jayanthdevendran-ctrl/Cirrus/3d models/cirrus.step

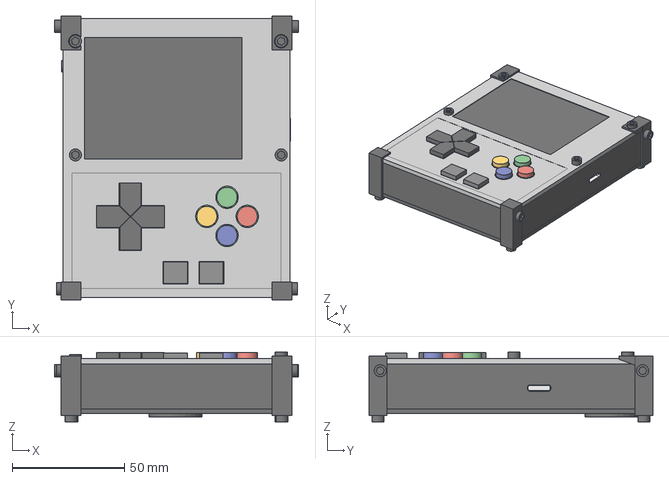
[picture p1: CAD file, 2026-11-02]
3d models/cirrus.step
108.6 x 126.2 x 31.1 mm
