jayanthdevendran-ctrl/Cirrus/(list of files, cad)

Other CAD files:
3d models/cirrus.f3d
3d models/cirrus.stl
