jayanthdevendran-ctrl/Cirrus/WiringDiagram/WiringDiagram.png

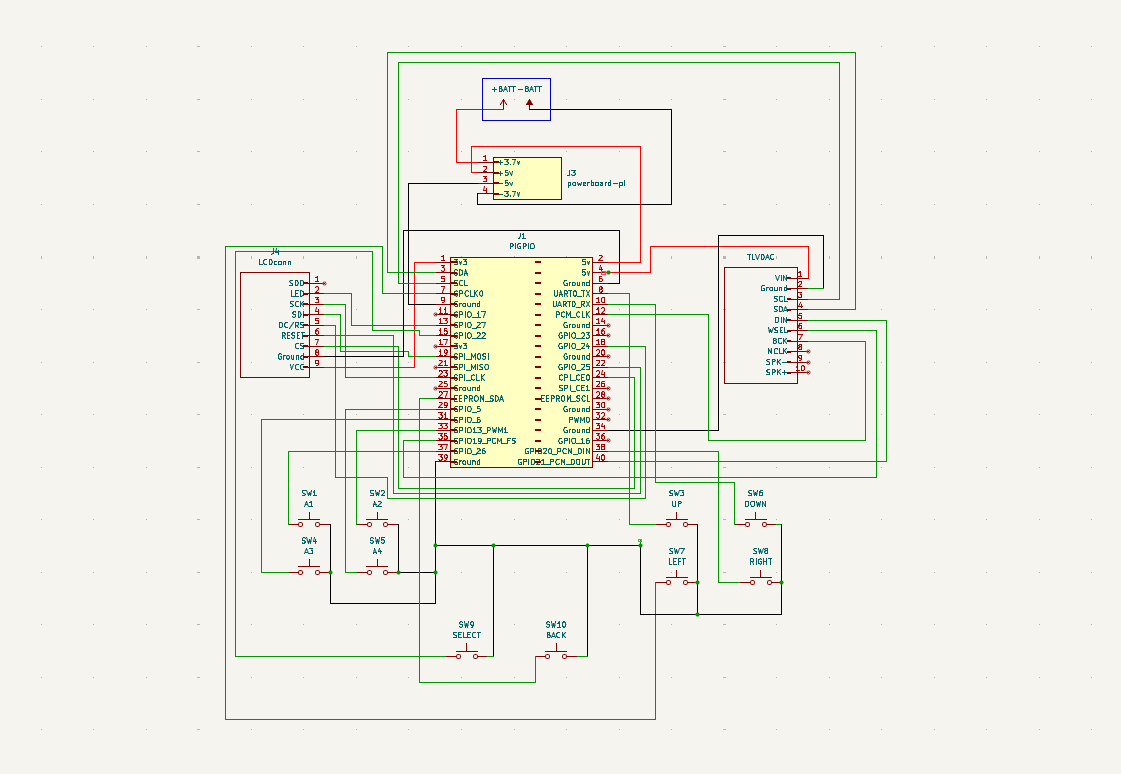
WiringDiagram/WiringDiagram.png
