jayanthdevendran-ctrl/Cirrus/WiringDiagram/cirrus.kicad_sch

## KiCad design WiringDiagram/cirrus.kicad_sch (2026-11-02)

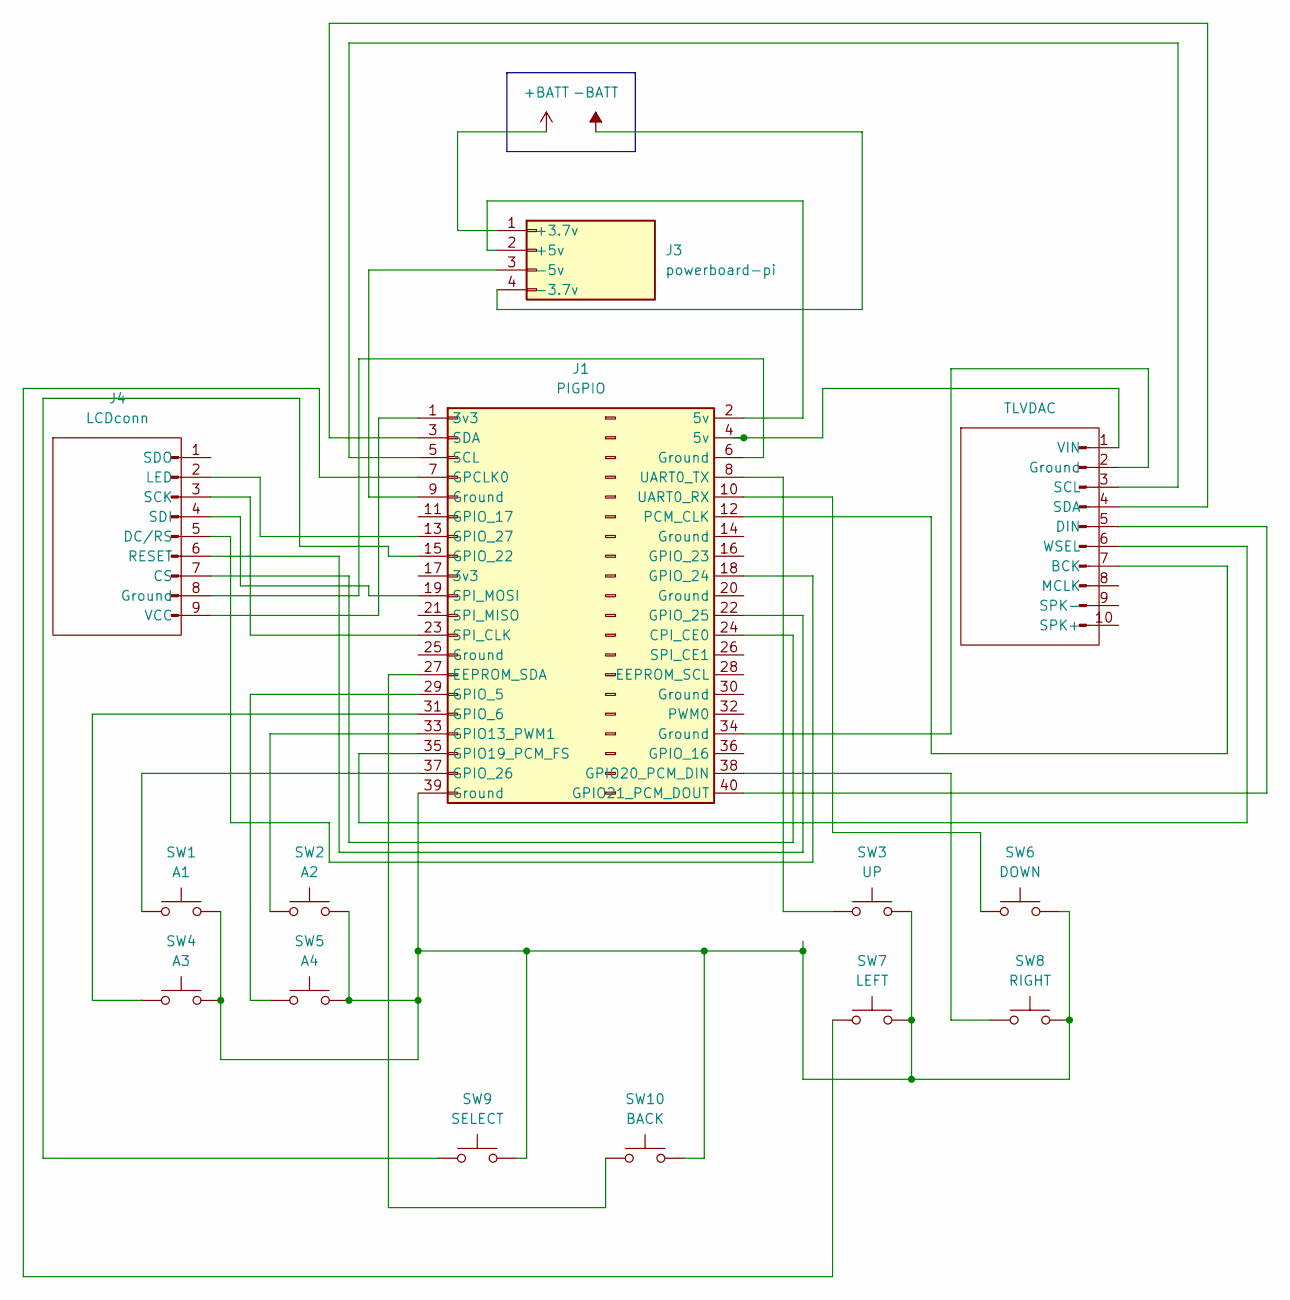
[picture p3: schematic cirrus.kicad_sch]

Parts:
J1: PIGPIO
J2: TLVDAC
J3: powerboard-pi
J4: LCDconn; LCD-016N002L
SW1: A1
SW2: A2
SW3: UP
SW4: A3
SW5: A4
SW6: DOWN
SW7: LEFT
SW8: RIGHT
SW9: SELECT
SW10: BACK

Connections:
+BATT: J3.1 (+3.7v)
-BATT: J3.4 (-3.7v)
unnamed: J1.1 (3v3), J4.9 (VCC)
unnamed: J1.2 (5v), J3.2 (+5v)
unnamed: J1.3 (SDA), J2.4 (SDA)
unnamed: J1.4 (5v), J2.1 (VIN)
unnamed: J1.5 (SCL), J2.3 (SCL)
unnamed: J1.6 (Ground), J4.8 (Ground)
unnamed: J1.7 (GPCLK0), SW7.1
unnamed: J1.8 (UART0_TX), SW3.1
unnamed: J1.9 (Ground), J3.3 (-5v)
unnamed: J1.10 (UART0_RX), SW6.1
unnamed: J1.12 (PCM_CLK), J2.7 (BCK)
unnamed: J1.13 (GPIO_27), J4.2 (LED)
unnamed: J1.15 (GPIO_22), SW9.1
unnamed: J1.18 (GPIO_24), J4.5 (DC/RS)
unnamed: J1.19 (SPI_MOSI), J4.4 (SDI)
unnamed: J1.22 (GPIO_25), J4.6 (RESET)
unnamed: J1.23 (SPI_CLK), J4.3 (SCK)
unnamed: J1.24 (CPI_CE0), J4.7 (CS)
unnamed: J1.27 (EEPROM_SDA), SW10.1
unnamed: J1.29 (GPIO_5), SW5.1
unnamed: J1.31 (GPIO_6), SW4.1
unnamed: J1.33 (GPIO13_PWM1), SW2.1
unnamed: J1.34 (Ground), J2.2 (Ground)
unnamed: J1.35 (GPIO19_PCM_FS), J2.6 (WSEL)
unnamed: J1.37 (GPIO_26), SW1.1
unnamed: J1.38 (GPIO20_PCM_DIN), SW8.1
unnamed: J1.39 (Ground), SW1.2, SW2.2, SW3.2, SW4.2, SW5.2, SW6.2, SW7.2, SW8.2, SW9.2, SW10.2
unnamed: J1.40 (GPIO21_PCM_DOUT), J2.5 (DIN)
