jayanthdevendran-ctrl/Cirrus/(commit log)

2026-06-22 started menu code to switch between submenus
2026-06-27 switching from list to dictionaries
2026-08-05 added camera function
2026-08-08 added liked songs, playlists and currently playing
2026-11-02 Update README with Bill of Materials
    Added a detailed Bill of Materials (BOM) with item descriptions, quantities, links, and prices.
2026-11-03 Update README with camera information
    Added a section about the camera setup and photo exporting.
